mcospin88/Entrega-Proyecto-Final-Electronica-2-y-Diseno-Electronico-1/BOM/BOM_PCIe_Switch_PI7C9X3G808GP.csv

Comment | Designator | Footprint | LCSC Part # | Quantity
HI1812V101R-10 | BD1,BD3,BD5,BD6,BD7,BD9 | L1812 | C2442066 | 6
22uF25V | C7,C8,C20,C90,C91,C92,C93,C94,C95,C98,C99,C102,C103,C356,C358,C599,C604,C624 | C1206 | C12891 | 18
0.1uF | C9,C10,C21,C55,C56,C126,C220,C225,C230,C233,C234,C241,C242,C257,C269,C270,C282,C298,C299,C303,C310,C311,C357,C359,C600,C601,C602,C605,C606,C607,C612,C616,C617,C667 | C0402 | C1525 | 34
10uF10V | C54,C603,C608 | C0603 | C19702 | 3
10uF/6.3V | C219,C223,C228,C244,C255,C267,C279,C301,C308,C614,C619 | C0402 | C15525 | 11
4.7uF/6.3V | C224,C229,C240,C245,C256,C268,C302,C309,C611,C615,C620 | C0402 | C76996 | 11
100UF6.3V | C265,C266 | C1206 | C15008 | 2
47uF6.3V | C307,C609,C610,C613,C618 | C0805 | C16780 | 5
22uF | C621 | C1206 | C12891 | 1
1uF | C622,C623 | C0603 | C5673 | 2
12pF | C625 | C0402 | C1547 | 1
47uF | C626 | C1206 | C68361 | 1
10uF25V | C627,C629,C635,C637 | C0805 | C15850 | 4
100nF | C628,C630,C636,C638 | C0402 | C1525 | 4
150pF | C631,C634 | C0402 | C1527 | 2
100uF | C632,C639 | C1206 | C15008 | 2
2.2uF | C633,C640 | C0603 | C1607 | 2
0.22uF | C641,C642,C643,C644,C645,C646,C649,C650,C651,C652,C653,C654,C655,C656,C665,C666 | C0402 | C16772 | 16
Red | DS1,DS4,DS6,DS7 | LED-0805 | C84256 | 4
APCI0079-P002A | J4,J5,J6,J7 | M2_APCI0079 | C841651 | 4
PWRCONN6P | PWR2 | 455580003 | C7545781 | 1
2N7002 | Q1,Q2 | SOT23SGD_T | C8545 | 2
1K | R17,R590 | R0402 | C11702 | 2
330R | R20,R28,R30,R581,R582,R583,R584,R585,R586,R587,R588,RD5,RD93,RD94 | R0402 | C25104 | 14
0R | R37,R40,R157,R158,R321,R322,R517,R518,R519,R521,R523,R525,R527,R547,R548,R549,R550,R551,R552,R553,R554,R555,R556,R557,R558,R559,R560 | R0402 | C17168 | 27
5.1k | R79,R80,R520,R524,R526 | R0402 | C25905 | 5
200R1% | R149 | R0402 | C25087 | 1
3.9K1% | R509 | R0402 | C51721 | 1
20K1% | R511,R531 | R0402 | C25765 | 2
24.9K1% | R530 | R0402 | C25874 | 1
10k | R532,R536,R540,R541,R545,R546 | R0402 | C25744 | 6
11.8k | R533,R538,R544 | R0402 | C93752 | 3
4.02k | R534 | R0402 | C43251 | 1
56k | R535 | R0402 | C25796 | 1
2.21k | R537,R543 | R0402 | C25880 | 2
9.09k | R539,R542 | R0402 | C11549 | 2
5.1K | R561,R562,R563,R564,R565,R566,R567,R568,R569,R570,R571,R572,R573,R574,R575,R576,R577,R578,R579,R580,RP116 | R0402 | C25905 | 21
10K | R589 | R0402 | C25744 | 1
1.2K | R591 | R0402 | C25862 | 1
PCI Express x4 Connector | SLOT1,SLOT2,SLOT3 | PCI_EXP_SLOT_X4 | C4597619 | 3
PI7C9X3G808GP | U6 | HFCBGA_196_15X15 | C9900017867 | 1
SN74AHC1G126DBVR | U7 | SOT95P285X140-5N | C145145 | 1
AP7361C-FGE-7 | U53,U54 | DFN8-0303-_65 | C460398 | 2
TPSM843B22RDG | U56 | RDG0025A-MFG | C19183947 | 1
TPSM843620MSITR | U57,U58 | USIP15_SIT_TEX | C33512571 | 2
