mcospin88/Entrega-Proyecto-Final-Electronica-2-y-Diseno-Electronico-1/(list of files, drawings)

Other design files:
Esquematico/PI7C9X3G808GP FINAL.DSN
