mcospin88/Entrega-Proyecto-Final-Electronica-2-y-Diseno-Electronico-1/(commit log)

2026-11-09 Subo el esquematico
    [PI7C9X3G808GP FINAL.DSN]
2026-11-09 Subo el layout de la PCB
    [PCIE_SWITCH_REVB.brd]
2026-11-09 Subo el BOM
    [BOM_PCIe_Switch_PI7C9X3G808GP.csv]
2026-11-09 Subo los gerbers y taladros
    [PCIE_SWITCH_REVB-NPTH.drl, PCIE_SWITCH_REVB-PTH.drl, PCIE_SWITCH_REVB.GBL, PCIE_SWITCH_REVB.GBO, PCIE_SWITCH_REVB.GBP, PCIE_SWITCH_REVB.GBS, PCIE_SWITCH_REVB.GKO, PCIE_SWITCH_REVB.GTL]
2026-11-09 Agrego imagen de la placa
